GadgetReboot/ATTiny_LFO/README.md

# ATTiny_LFO
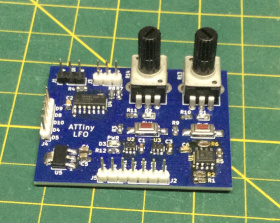
[picture p1: Assembled_PCB.jpg]
PCB
<br><br><BR><BR>
Dual low frequency oscillators using ATTiny and MCP4725 DACs
