GadgetReboot/ATTiny_LFO/Sch_ATTiny_LFO.pdf

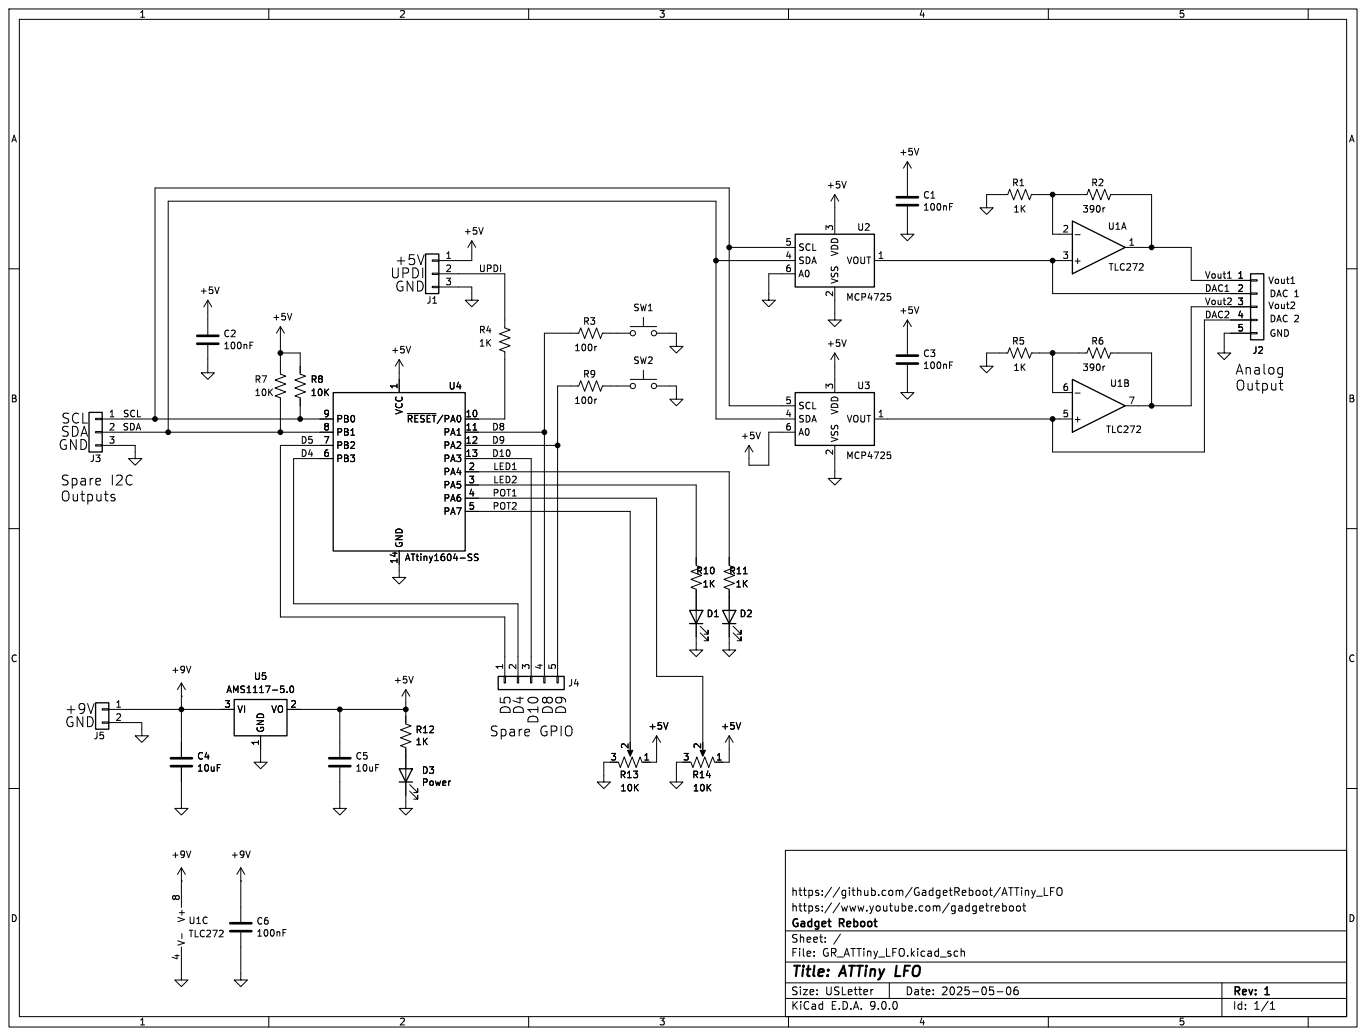
[picture p2: page 1]

2 VOUT 1 U2 MCP4725 +5V D2 SCL 5 SDA 4 A0 6 VDD

https://github.com/GadgetReboot/ATTiny_LFO

Id: 1/1 Title: ATTiny LFO
