GadgetReboot/ATTiny_LFO/KiCad/GR_ATTiny_LFO.kicad_pcb

## KiCad design KiCad/GR_ATTiny_LFO.kicad_pcb (2025-05-30)

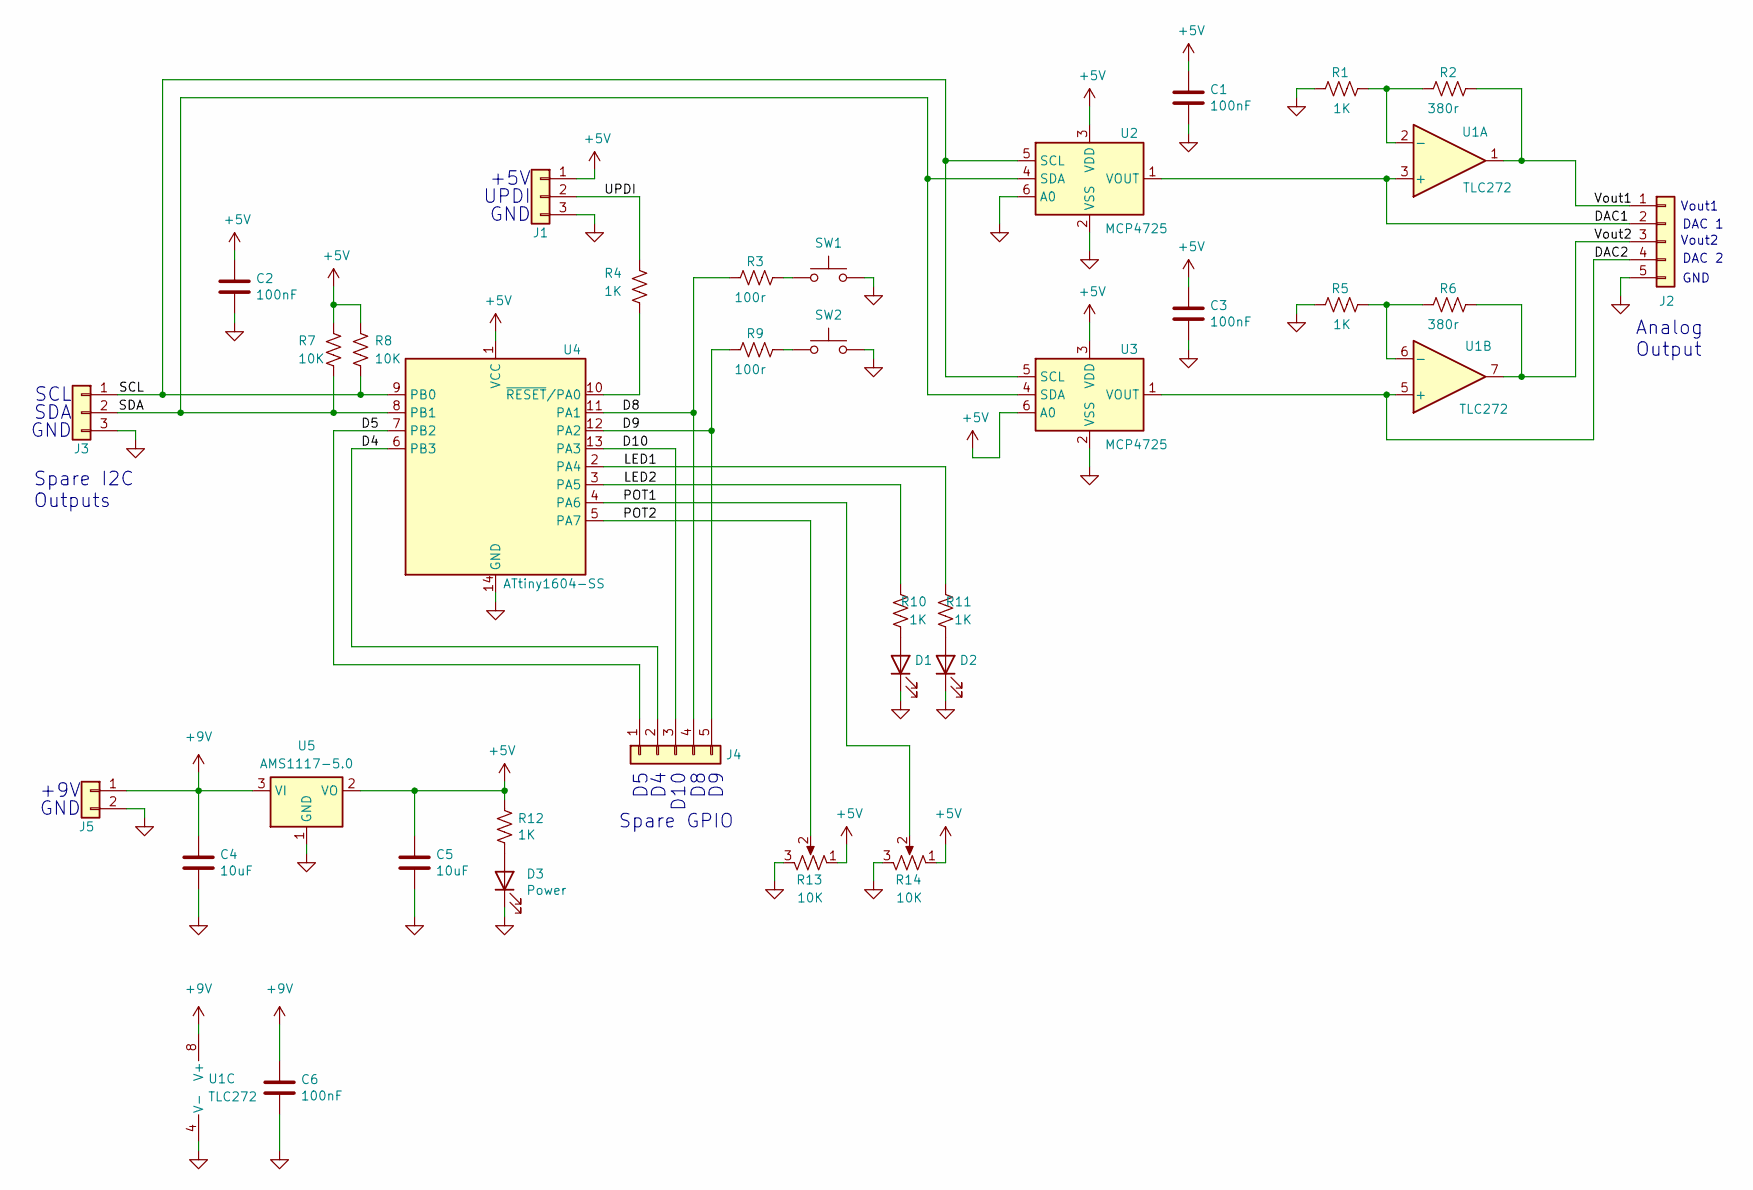
[picture p3: schematic GR_ATTiny_LFO.kicad_sch, ATTiny LFO]

Parts:
C1, C3, C6: 100nF; C_0805_2012Metric_Pad1.15x1.40mm_HandSolder
C2: 100nF; C_0805_2012Metric_Pad1.18x1.45mm_HandSolder
C4, C5: 10uF; C_0805_2012Metric_Pad1.15x1.40mm_HandSolder
D1, D2: LED; LED_0805_2012Metric_Pad1.15x1.40mm_HandSolder
D3: Power; LED_0805_2012Metric_Pad1.15x1.40mm_HandSolder
J1, J3: Conn_01x03; PinHeader_1x03_P2.54mm_Vertical
J2, J4: Conn_01x05; PinHeader_1x05_P2.54mm_Vertical
J5: 1x2; PinHeader_1x02_P2.54mm_Vertical
R1, R4, R5, R10, R11, R12: 1K; R_0805_2012Metric_Pad1.15x1.40mm_HandSolder
R2, R6: 380r; R_0805_2012Metric_Pad1.15x1.40mm_HandSolder
R3, R9: 100r; R_0805_2012Metric_Pad1.15x1.40mm_HandSolder
R7, R8: 10K; R_0805_2012Metric_Pad1.15x1.40mm_HandSolder
R13, R14: 10K; Potentiometer_Bourns_PTV09A-1
SW1, SW2: SW_Push; SW_SPST_60x35
U1: TLC272; SOIC-8_3.9x4.9mm_P1.27mm
U2, U3: MCP4725; SOT-23-6
U4: ATtiny1604-SS; SOIC-14_3.9x8.7mm_P1.27mm
U5: AMS1117-5.0; SOT-223-3_TabPin2

Connections:
+5V: C1.1, C2.1, C3.1, C5.1, J1.1, R7.1, R8.1, R12.1, R13.1, R14.1, U2.3 (VDD), U3.3 (VDD), U3.6 (A0), U4.1 (VCC), U5.2 (VO)
+9V: C4.1, C6.1, J5.1, U1.8 (V+), U5.3 (VI)
/D4: J4.2, U4.6 (PB3)
/D5: J4.1, U4.7 (PB2)
/D8: J4.4, R3.1, U4.11 (PA1)
/D9: J4.5, R9.1, U4.12 (PA2)
/D10: J4.3, U4.13 (PA3)
/DAC1: J2.2, U1.3 (+), U2.1 (VOUT)
/DAC2: J2.4, U1.5 (+), U3.1 (VOUT)
/LED1: R11.2, U4.2 (PA4)
/LED2: R10.2, U4.3 (PA5)
/POT1: R14.2, U4.4 (PA6)
/POT2: R13.2, U4.5 (PA7)
/SCL: J3.1, R8.2, U2.5 (SCL), U3.5 (SCL), U4.9 (PB0)
/SDA: J3.2, R7.2, U2.4 (SDA), U3.4 (SDA), U4.8 (PB1)
/UPDI: J1.2, R4.1
/Vout1: J2.1, R2.2, U1.1
/Vout2: J2.3, R6.2, U1.7
GND: C1.2, C2.2, C3.2, C4.2, C5.2, C6.2, D1.1 (K), D2.1 (K), D3.1 (K), J1.3, J2.5, J3.3, J5.2, R1.1, R5.1, R13.3, R14.3, SW1.2, SW2.2, U1.4 (V-), U2.2 (VSS), U2.6 (A0), U3.2 (VSS), U4.14 (GND), U5.1 (GND)
unnamed: D1.2 (A), R10.1
unnamed: D2.2 (A), R11.1
unnamed: D3.2 (A), R12.2
unnamed: R3.2, SW1.1
unnamed: R9.2, SW2.1
unnamed: R1.2, R2.1, U1.2 (-)
unnamed: R5.2, R6.1, U1.6 (-)
unnamed: R4.2, U4.10 (~RESET/PA0)

Notes on the sheet:
UPDI
GND
Spare GPIO
+5V
SDA
+9V
Spare I2C Outputs
DAC 2
D10
Vout2
Vout1
DAC 1
SCL
Analog Output

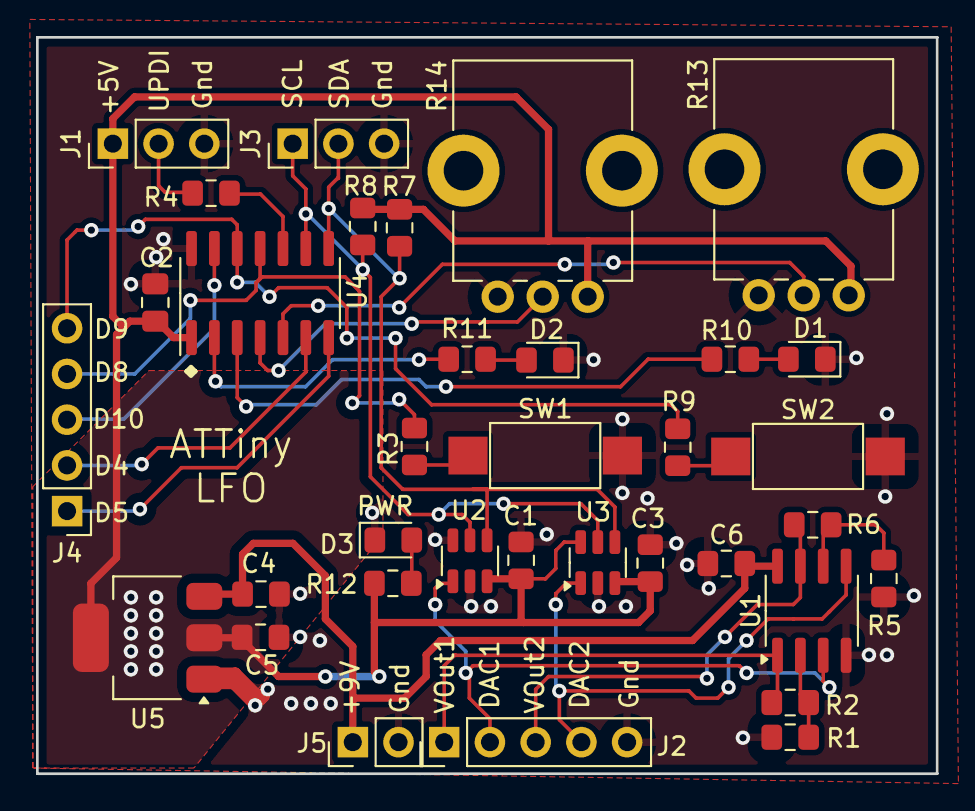
[picture p4: board GR_ATTiny_LFO.kicad_pcb from above]

Board: 2 copper layers, 50.0 x 40.9 mm, 35 parts (0 on the bottom side), 27 nets.
